baconspoon85/phoenix45_alpha/Vault45_Alpha/vault45-alpha-bottom-row-options.png

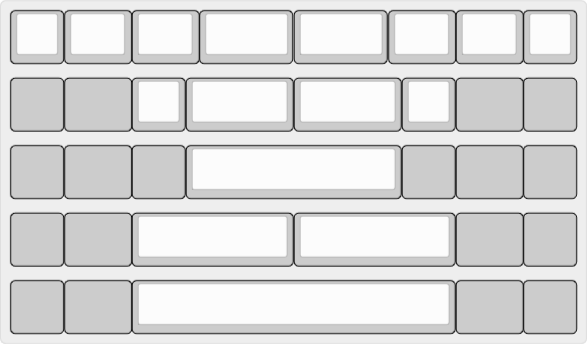
Vault45_Alpha/vault45-alpha-bottom-row-options.png
