baconspoon85/phoenix45_alpha/Vault45_Alpha/Vault45_Alpha_FR4_Plate_Center_Switch_Blocker_Cutouts/vault45_alpha_plate_center_switch_blocker_cutouts.dxf

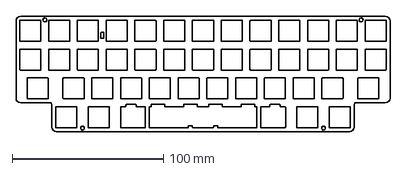
[picture p2: CAD file, 2023-09-07]
Vault45_Alpha/Vault45_Alpha_FR4_Plate_Center_Switch_Blocker_Cutouts/vault45_alpha_plate_center_switch_blocker_cutouts.dxf
247.6 x 76.2 mm
