baconspoon85/phoenix45_alpha/Vault45_Alpha/Vault45_Alpha_FR4_Plate/legacy_vault_45_alpha_plate.dxf

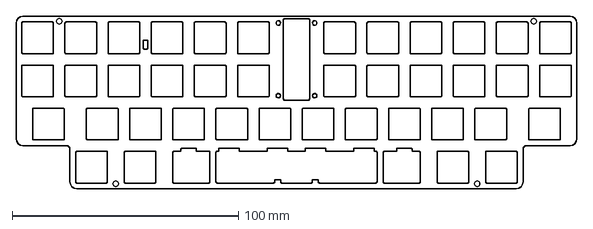
[picture p3: CAD file, 2023-09-07, an earlier design]
Vault45_Alpha/Vault45_Alpha_FR4_Plate/legacy_vault_45_alpha_plate.dxf
247.6 x 76.2 mm
