baconspoon85/phoenix45_alpha/Vault45_Alpha/Vault45_alpha.kicad_pcb

## KiCad design Vault45_Alpha/Vault45_alpha.kicad_pcb (2023-09-03)

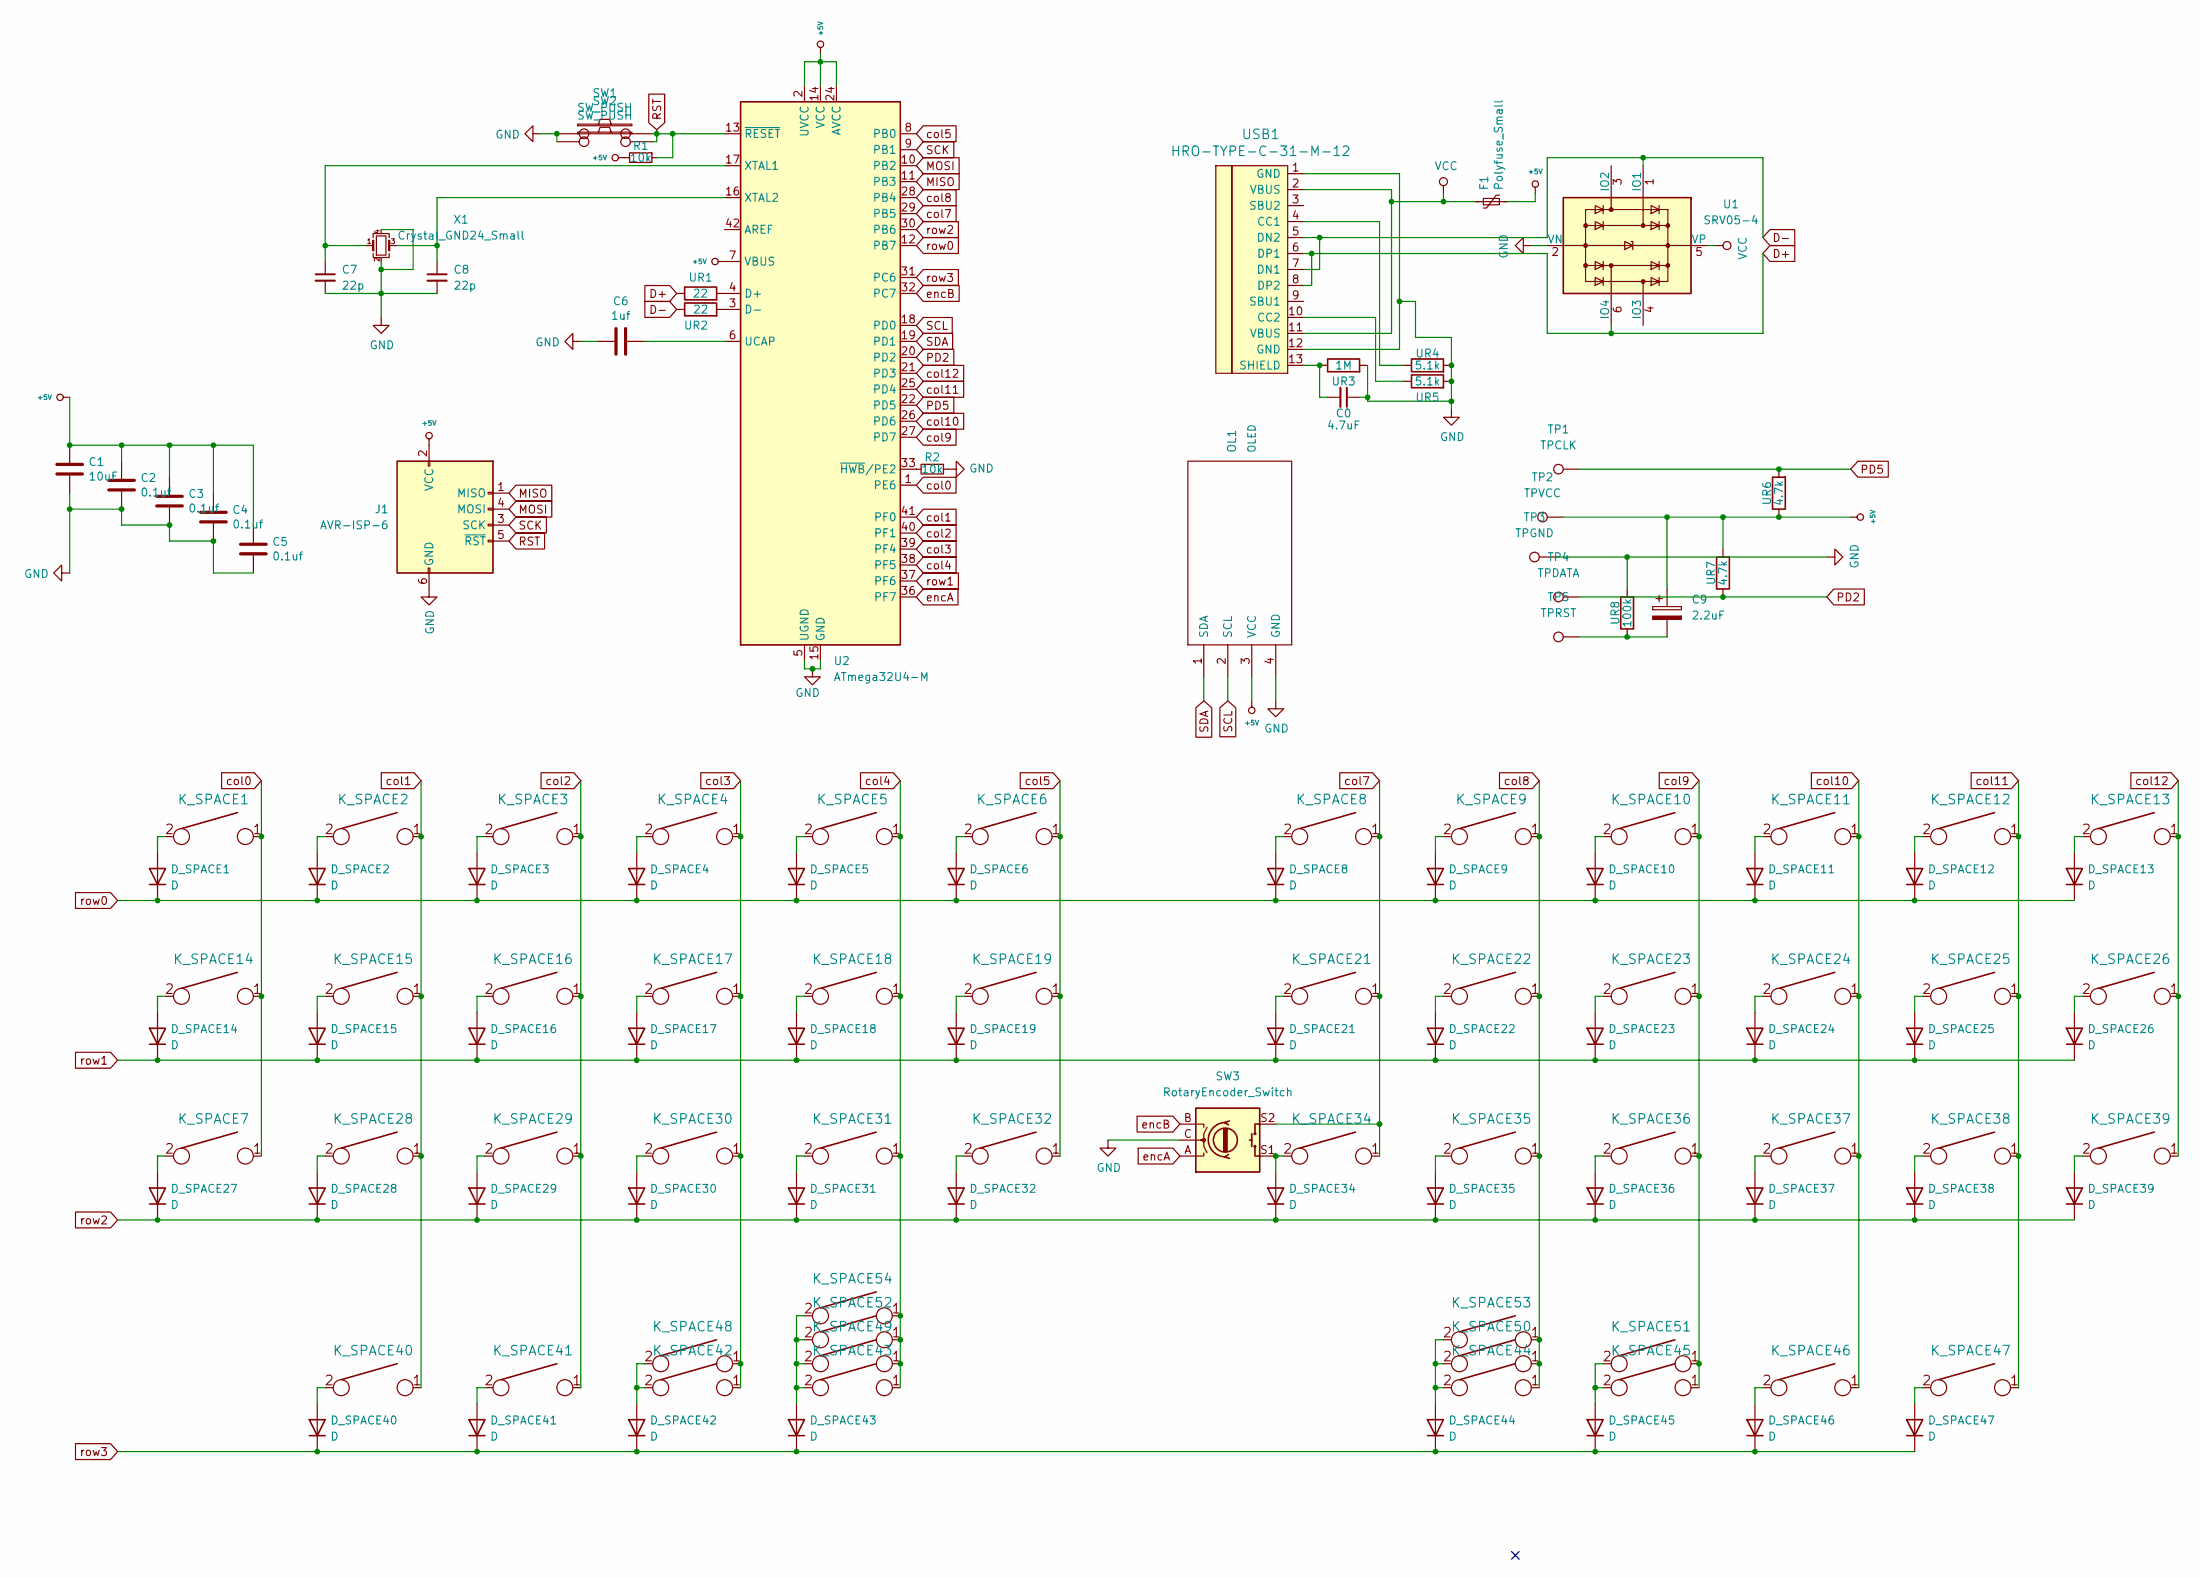
[picture p4: schematic Vault45_alpha.kicad_sch]

Parts:
C0: 4.7uF; C_0805_2012Metric_Pad1.18x1.45mm_HandSolder
C1: 10uF; C_0805_2012Metric_Pad1.18x1.45mm_HandSolder
C2, C3, C4, C5: 0.1uf; C_0805_2012Metric_Pad1.18x1.45mm_HandSolder
C6: 1uf; C_0805_2012Metric_Pad1.18x1.45mm_HandSolder
C7, C8: 22p; C_0805_2012Metric_Pad1.18x1.45mm_HandSolder
C9: 2.2uF; C_0805_2012Metric_Pad1.18x1.45mm_HandSolder
D_SPACE1, D_SPACE2, D_SPACE3, D_SPACE4, D_SPACE5, D_SPACE6, D_SPACE8, D_SPACE9, D_SPACE10, D_SPACE11, D_SPACE12, D_SPACE13, D_SPACE14, D_SPACE15, D_SPACE16, D_SPACE17, D_SPACE18, D_SPACE19, D_SPACE21, D_SPACE22, D_SPACE23, D_SPACE24, D_SPACE25, D_SPACE26, D_SPACE27, D_SPACE28, D_SPACE29, D_SPACE30, D_SPACE31, D_SPACE32, D_SPACE34, D_SPACE35, D_SPACE36, D_SPACE37, D_SPACE38, D_SPACE39, D_SPACE40, D_SPACE41, D_SPACE42, D_SPACE43, D_SPACE44, D_SPACE45, D_SPACE46, D_SPACE47: D; D_SOD-123
F1: Polyfuse_Small; Fuse_1206_3216Metric_Pad1.42x1.75mm_HandSolder
J1: AVR-ISP-6; IDC-Header_2x03_P2.54mm_Vertical
K_SPACE1, K_SPACE2, K_SPACE3, K_SPACE4, K_SPACE5, K_SPACE6, K_SPACE8, K_SPACE9, K_SPACE10, K_SPACE11, K_SPACE12, K_SPACE13, K_SPACE14, K_SPACE15, K_SPACE16, K_SPACE17, K_SPACE18, K_SPACE19, K_SPACE21, K_SPACE22, K_SPACE23, K_SPACE24, K_SPACE25, K_SPACE26, K_SPACE28, K_SPACE29, K_SPACE30, K_SPACE31, K_SPACE32, K_SPACE34, K_SPACE35, K_SPACE36, K_SPACE37, K_SPACE38, K_SPACE40, K_SPACE47, K_SPACE48, K_SPACE51: KEYSW; MXOnly-1U-NoLED
K_SPACE7, K_SPACE39: KEYSW; MXOnly-1.5U-NoLED
K_SPACE41, K_SPACE42, K_SPACE45, K_SPACE46: KEYSW; MXOnly-1.25U-NoLED
K_SPACE43, K_SPACE44: KEYSW; MXOnly-1.75U-NoLED
K_SPACE49, K_SPACE50: KEYSW; MXOnly-2U-ReversedStabilizers-NoLED
K_SPACE52, K_SPACE53: KEYSW; MXOnly-3U-ReversedStabilizers-NoLED
K_SPACE54: KEYSW; MXOnly-4U-ReversedStabilizers-NoLED
OL1: OLED; OLED_v2
R1, R2: 10k; R_0805_2012Metric_Pad1.20x1.40mm_HandSolder
SW1, SW2: SW_PUSH; SW_SPST_SKQG_WithoutStem
SW3: RotaryEncoder_Switch; RotaryEncoder_Alps_EC11E-Switch_Vertical_H20mm
TP1: TPCLK; TestPoint_THTPad_1.0x1.0mm_Drill0.5mm
TP2: TPVCC; TestPoint_THTPad_1.0x1.0mm_Drill0.5mm
TP3: TPGND; TestPoint_THTPad_1.0x1.0mm_Drill0.5mm
TP4: TPDATA; TestPoint_THTPad_1.0x1.0mm_Drill0.5mm
TP5: TPRST; TestPoint_THTPad_1.0x1.0mm_Drill0.5mm
U1: SRV05-4; SOT-23-6_Handsoldering
U2: ATmega32U4-M; QFN-44-1EP_7x7mm_P0.5mm_EP5.2x5.2mm_ThermalVias
UR1, UR2: 22; R_0805_2012Metric_Pad1.20x1.40mm_HandSolder
UR3: 1M; R_0805_2012Metric_Pad1.20x1.40mm_HandSolder
UR4, UR5: 5.1k; R_0805_2012Metric_Pad1.20x1.40mm_HandSolder
UR6, UR7: 4.7k; R_0805_2012Metric_Pad1.20x1.40mm_HandSolder
UR8: 100k; R_0805_2012Metric_Pad1.20x1.40mm_HandSolder
USB1: HRO-TYPE-C-31-M-12; HRO-TYPE-C-31-M-12-HandSoldering
X1: Crystal_GND24_Small; Crystal_SMD_3225-4Pin_3.2x2.5mm_HandSoldering

Connections:
+5V: C1.1, C2.1, C3.1, C4.1, C5.1, C9.1, F1.2, J1.2 (VCC), OL1.3 (VCC), R1.2, TP2.1, U2.2 (UVCC), U2.7 (VBUS), U2.14 (VCC), U2.24 (AVCC), U2.34 (VCC), U2.44 (AVCC), UR6.1, UR7.2
D+: U1.6 (IO4), UR2.1, USB1.6 (DP1), USB1.8 (DP2)
D-: U1.1 (IO1), UR1.1, USB1.5 (DN2), USB1.7 (DN1)
GND: C0.1, C1.2, C2.2, C3.2, C4.2, C5.2, C6.2, C7.2, C8.2, J1.6 (GND), OL1.4 (GND), R2.1, SW1.1, SW2.1, SW3.C, TP3.1, U1.2 (VN), U2.5 (UGND), U2.15 (GND), U2.23 (GND), U2.35 (GND), U2.43 (GND), U2.45 (GND), UR3.2, UR4.2, UR5.2, UR8.2, USB1.1 (GND), USB1.12 (GND), X1.2, X1.4
MISO: J1.1 (MISO), U2.11 (PB3)
MOSI: J1.4 (MOSI), U2.10 (PB2)
unnamed: C9.2, TP5.1, UR8.1
unnamed: D_SPACE1.2 (A), K_SPACE1.2
unnamed: D_SPACE2.2 (A), K_SPACE2.2
unnamed: D_SPACE3.2 (A), K_SPACE3.2
unnamed: D_SPACE4.2 (A), K_SPACE4.2
unnamed: D_SPACE5.2 (A), K_SPACE5.2
unnamed: D_SPACE6.2 (A), K_SPACE6.2
unnamed: D_SPACE8.2 (A), K_SPACE8.2
unnamed: D_SPACE9.2 (A), K_SPACE9.2
unnamed: D_SPACE10.2 (A), K_SPACE10.2
unnamed: D_SPACE11.2 (A), K_SPACE11.2
unnamed: D_SPACE12.2 (A), K_SPACE12.2
unnamed: D_SPACE13.2 (A), K_SPACE13.2
unnamed: D_SPACE14.2 (A), K_SPACE14.2
unnamed: D_SPACE15.2 (A), K_SPACE15.2
unnamed: D_SPACE16.2 (A), K_SPACE16.2
unnamed: D_SPACE17.2 (A), K_SPACE17.2
unnamed: D_SPACE18.2 (A), K_SPACE18.2
unnamed: D_SPACE19.2 (A), K_SPACE19.2
unnamed: D_SPACE21.2 (A), K_SPACE21.2
unnamed: D_SPACE22.2 (A), K_SPACE22.2
unnamed: D_SPACE23.2 (A), K_SPACE23.2
unnamed: D_SPACE24.2 (A), K_SPACE24.2
unnamed: D_SPACE25.2 (A), K_SPACE25.2
unnamed: D_SPACE26.2 (A), K_SPACE26.2
unnamed: D_SPACE27.2 (A), K_SPACE7.2
unnamed: D_SPACE28.2 (A), K_SPACE28.2
unnamed: D_SPACE29.2 (A), K_SPACE29.2
unnamed: D_SPACE30.2 (A), K_SPACE30.2
unnamed: D_SPACE31.2 (A), K_SPACE31.2
unnamed: D_SPACE32.2 (A), K_SPACE32.2
unnamed: D_SPACE34.2 (A), K_SPACE34.2, SW3.S1
unnamed: D_SPACE35.2 (A), K_SPACE35.2
unnamed: D_SPACE36.2 (A), K_SPACE36.2
unnamed: D_SPACE37.2 (A), K_SPACE37.2
unnamed: D_SPACE38.2 (A), K_SPACE38.2
unnamed: D_SPACE39.2 (A), K_SPACE39.2
unnamed: D_SPACE40.2 (A), K_SPACE40.2
unnamed: D_SPACE41.2 (A), K_SPACE41.2
unnamed: D_SPACE42.2 (A), K_SPACE42.2, K_SPACE48.2
unnamed: D_SPACE43.2 (A), K_SPACE43.2, K_SPACE49.2, K_SPACE52.2, K_SPACE54.2
unnamed: D_SPACE44.2 (A), K_SPACE44.2, K_SPACE50.2, K_SPACE53.2
unnamed: D_SPACE45.2 (A), K_SPACE45.2, K_SPACE51.2
unnamed: D_SPACE46.2 (A), K_SPACE46.2
unnamed: D_SPACE47.2 (A), K_SPACE47.2
unnamed: U2.4 (D+), UR2.2
unnamed: U2.3 (D-), UR1.2
unnamed: C6.1, U2.6 (UCAP)
unnamed: C7.1, U2.17 (XTAL1), X1.1
unnamed: C8.1, U2.16 (XTAL2), X1.3
unnamed: R2.2, U2.33 (~HWB/PE2)
unnamed: UR4.1, USB1.4 (CC1)
unnamed: UR5.1, USB1.10 (CC2)
unnamed: C0.2, UR3.1, USB1.13 (SHIELD)
PD2: TP4.1, U2.20 (PD2), UR7.1
PD5: TP1.1, U2.22 (PD5), UR6.2
RST: J1.5 (~RST), R1.1, SW1.2, SW2.2, U2.13 (~RESET)
SCK: J1.3 (SCK), U2.9 (PB1)
SCL: OL1.2 (SCL), U2.18 (PD0)
SDA: OL1.1 (SDA), U2.19 (PD1)
VCC: F1.1, U1.5 (VP), USB1.2 (VBUS), USB1.11 (VBUS)
col0: K_SPACE1.1, K_SPACE7.1, K_SPACE14.1, U2.1 (PE6)
col1: K_SPACE2.1, K_SPACE15.1, K_SPACE28.1, K_SPACE40.1, U2.41 (PF0)
col2: K_SPACE3.1, K_SPACE16.1, K_SPACE29.1, K_SPACE41.1, U2.40 (PF1)
col3: K_SPACE4.1, K_SPACE17.1, K_SPACE30.1, K_SPACE42.1, K_SPACE48.1, U2.39 (PF4)
col4: K_SPACE5.1, K_SPACE18.1, K_SPACE31.1, K_SPACE43.1, K_SPACE49.1, K_SPACE52.1, K_SPACE54.1, U2.38 (PF5)
col5: K_SPACE6.1, K_SPACE19.1, K_SPACE32.1, U2.8 (PB0)
col7: K_SPACE8.1, K_SPACE21.1, K_SPACE34.1, SW3.S2, U2.29 (PB5)
col8: K_SPACE9.1, K_SPACE22.1, K_SPACE35.1, K_SPACE44.1, K_SPACE50.1, K_SPACE53.1, U2.28 (PB4)
col9: K_SPACE10.1, K_SPACE23.1, K_SPACE36.1, K_SPACE45.1, K_SPACE51.1, U2.27 (PD7)
col10: K_SPACE11.1, K_SPACE24.1, K_SPACE37.1, K_SPACE46.1, U2.26 (PD6)
col11: K_SPACE12.1, K_SPACE25.1, K_SPACE38.1, K_SPACE47.1, U2.25 (PD4)
col12: K_SPACE13.1, K_SPACE26.1, K_SPACE39.1, U2.21 (PD3)
encA: SW3.A, U2.36 (PF7)
encB: SW3.B, U2.32 (PC7)
row0: D_SPACE1.1 (K), D_SPACE2.1 (K), D_SPACE3.1 (K), D_SPACE4.1 (K), D_SPACE5.1 (K), D_SPACE6.1 (K), D_SPACE8.1 (K), D_SPACE9.1 (K), D_SPACE10.1 (K), D_SPACE11.1 (K), D_SPACE12.1 (K), D_SPACE13.1 (K), U2.12 (PB7)
row1: D_SPACE14.1 (K), D_SPACE15.1 (K), D_SPACE16.1 (K), D_SPACE17.1 (K), D_SPACE18.1 (K), D_SPACE19.1 (K), D_SPACE21.1 (K), D_SPACE22.1 (K), D_SPACE23.1 (K), D_SPACE24.1 (K), D_SPACE25.1 (K), D_SPACE26.1 (K), U2.37 (PF6)
row2: D_SPACE27.1 (K), D_SPACE28.1 (K), D_SPACE29.1 (K), D_SPACE30.1 (K), D_SPACE31.1 (K), D_SPACE32.1 (K), D_SPACE34.1 (K), D_SPACE35.1 (K), D_SPACE36.1 (K), D_SPACE37.1 (K), D_SPACE38.1 (K), D_SPACE39.1 (K), U2.30 (PB6)
row3: D_SPACE40.1 (K), D_SPACE41.1 (K), D_SPACE42.1 (K), D_SPACE43.1 (K), D_SPACE44.1 (K), D_SPACE45.1 (K), D_SPACE46.1 (K), D_SPACE47.1 (K), U2.31 (PC6)

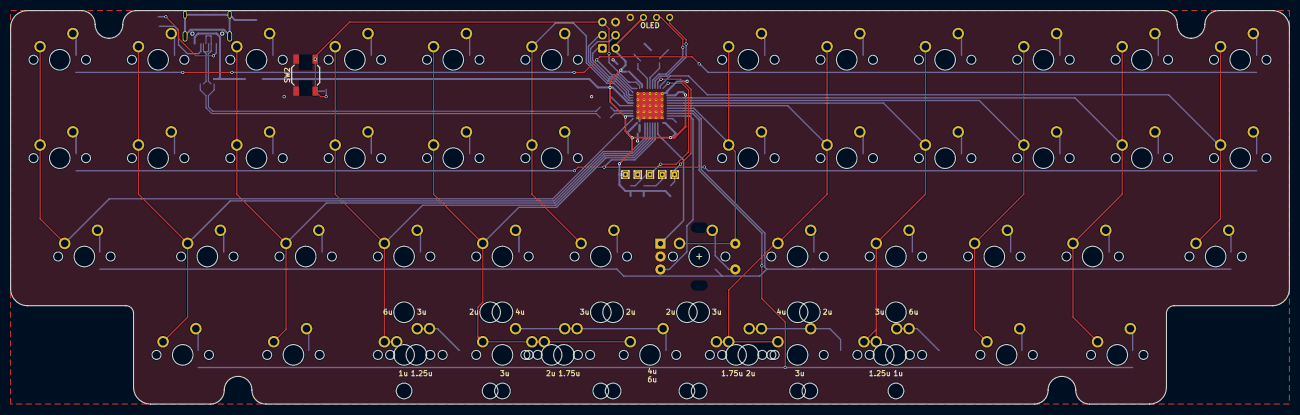
[picture p5: board Vault45_alpha.kicad_pcb from above]

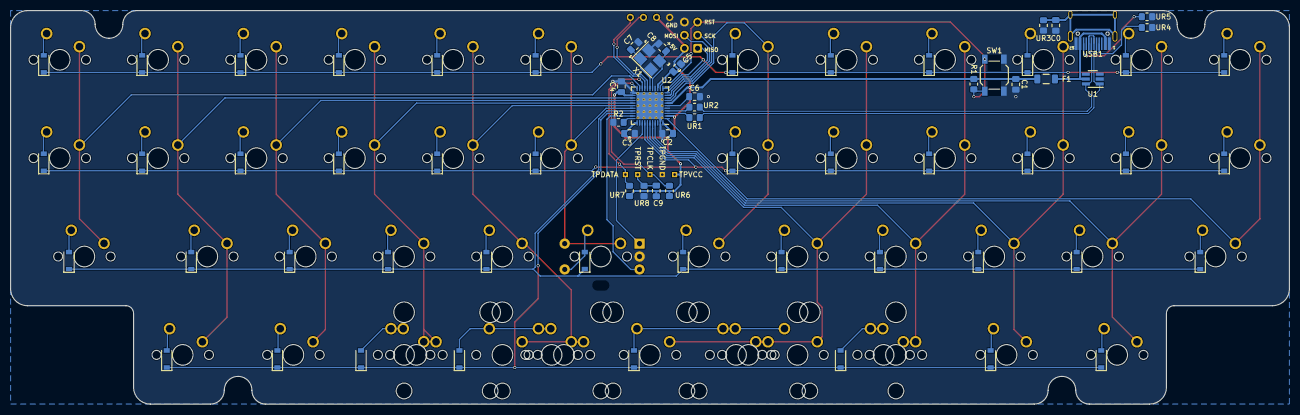
[picture p6: board Vault45_alpha.kicad_pcb from below]

Board: 2 copper layers, 247.7 x 76.2 mm, 130 parts (71 on the bottom side), 85 nets.
