baconspoon85/phoenix45_alpha/(commit log)

2023-08-25 initial commit for vault45 version of phoenix45 alpha
    [Vault45_alpha-B_Cu.gbl, Vault45_alpha-B_Mask.gbs, Vault45_alpha-B_Paste.gbp, Vault45_alpha-B_Silkscreen.gbo, Vault45_alpha-Edge_Cuts.gm1, Vault45_alpha-F_Cu.gtl, Vault45_alpha-F_Mask.gts, Vault45_alpha-F_Paste.gtp]
2023-08-26 updated pcb layout to address interference with plate mounting hardware and added custom plate files
    [Vault45_Alpha_FR4_Plate-B_Cu.gbl, Vault45_Alpha_FR4_Plate-B_Mask.gbs, Vault45_Alpha_FR4_Plate-B_Paste.gbp, Vault45_Alpha_FR4_Plate-B_Silkscreen.gbo, Vault45_Alpha_FR4_Plate-Edge_Cuts.gm1, Vault45_Alpha_FR4_Plate-F_Cu.gtl, Vault45_Alpha_FR4_Plate-F_Mask.gts, Vault45_Alpha_FR4_Plate-F_Paste.gtp]
2023-08-26 added position file to Fabrication dir for Vault45 Alpha PCB
    [Vault45_alpha-all-pos.csv]
2023-09-03 Added bottom row options to Vault 45 Alpha PCB and updated fabrication files.
    [Vault45_alpha-B_Courtyard.gbr, Vault45_alpha-B_Cu.gbl, Vault45_alpha-B_Fab.gbr, Vault45_alpha-B_Mask.gbs, Vault45_alpha-B_Paste.gbp, Vault45_alpha-B_Silkscreen.gbo, Vault45_alpha-Edge_Cuts.gm1, Vault45_alpha-F_Courtyard.gbr]
2023-09-07 Updated plate DXF and FR4 KiCad project to accommodate all pottom row options on PCB
    [Vault45_Alpha_FR4_Plate-B_Cu.gbl, Vault45_Alpha_FR4_Plate-B_Mask.gbs, Vault45_Alpha_FR4_Plate-B_Paste.gbp, Vault45_Alpha_FR4_Plate-B_Silkscreen.gbo, Vault45_Alpha_FR4_Plate-Edge_Cuts.gm1, Vault45_Alpha_FR4_Plate-F_Cu.gtl, Vault45_Alpha_FR4_Plate-F_Mask.gts, Vault45_Alpha_FR4_Plate-F_Paste.gtp]
2023-09-07 Added BOM and POS files to Fabrication directory.Files are properly formatted for JLCPCB. BOM nets.
    [Vault45_alpha-BOM.csv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]
2023-09-07 Added kicad project file and gerbers for a plate with switch cutouts for 1u blockers or dummy switches in the center column instead of an OLED cutout. Added BOM to Vault45_Alpha/Fabrication dir, form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
    [Vault45_Alpha_FR4_Plate_Switch_Blocker_Cutouts-B_Cu.gbl, Vault45_Alpha_FR4_Plate_Switch_Blocker_Cutouts-B_Mask.gbs, Vault45_Alpha_FR4_Plate_Switch_Blocker_Cutouts-B_Paste.gbp, Vault45_Alpha_FR4_Plate_Switch_Blocker_Cutouts-B_Silkscreen.gbo, Vault45_Alpha_FR4_Plate_Switch_Blocker_Cutouts-Edge_Cuts.gm1, Vault45_Alpha_FR4_Plate_Switch_Blocker_Cutouts-F_Cu.gtl, Vault45_Alpha_FR4_Plate_Switch_Blocker_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]
2023-10-24 Update Vault45_alpha-BOM.csv
    Corrected part number for crystal. Original part number was for a 12MHz crystal. This needs to be a 16MHz crystal in the same SMD 3225 package.
    [Vault45_alpha-BOM.csv]
